Pletea-Marinescu-Valentin/Stabilization-Platform/results/tables/cost.tex

\begin{table}[!ht]
\centering
\caption{Cost of one update on the \SI{600}{\mega\hertz} Cortex-M7, against a \SI{31.25}{\milli\second} budget.}
\label{tab:cost}
\begin{tabular}{lccc}
\toprule
Controller & flops & time [\si{\micro\second}] & budget [\%] \\
\midrule
PID & 14 & 0.023 & 0.0001 \\
RST & 16 & 0.027 & 0.0001 \\
LQR & 12 & 0.020 & 0.0001 \\
LQG & 26 & 0.043 & 0.0001 \\
MRAC & 60 & 0.100 & 0.0003 \\
\bottomrule
\end{tabular}
\end{table}
