Pletea-Marinescu-Valentin/Stabilization-Platform/results/tables/results_acq.tex

\begin{table}[!ht]
\centering
\caption{Acquisition window (\SIrange{1}{20}{\second}): recovery from a \SI{6}{\degree} step of base tilt. Score is normalised against the best controller in each row group; lower is better.}
\label{tab:acq}
\footnotesize
\setlength{\tabcolsep}{3pt}
\begin{tabular}{llccccc}
\toprule
Case & Ctrl & RMSE & IAE & Peak & Effort & Score \\
\midrule
\multicolumn{7}{l}{\textit{Roll axis}} \\
Empty cup & PID & 0.51 & 1.5 & 5.99 & 0.19 & 1.12 \\
 & RST & 0.59 & 1.8 & \textbf{5.99} & \textbf{0.18} & 1.25 \\
 & LQR & \textbf{0.47} & \textbf{1.2} & 6.01 & 0.23 & \textbf{1.04} \\
 & LQG & 0.55 & 1.6 & 6.00 & 0.20 & 1.18 \\
 & MRAC & 0.59 & 2.1 & 5.99 & 0.18 & 1.35 \\
\addlinespace[2pt]
Half full & PID & 0.51 & 1.9 & 5.99 & 0.20 & \textbf{1.06} \\
 & RST & 0.59 & \textbf{1.8} & \textbf{5.99} & \textbf{0.18} & 1.06 \\
 & LQR & \textbf{0.47} & 2.0 & 6.01 & 0.27 & 1.11 \\
 & LQG & 0.55 & 2.0 & 6.00 & 0.22 & 1.11 \\
 & MRAC & 0.59 & 2.0 & 5.99 & 0.19 & 1.11 \\
\addlinespace[2pt]
Three-quarters full & PID & 0.51 & 2.0 & 5.99 & 0.20 & 1.07 \\
 & RST & 0.59 & \textbf{1.8} & \textbf{5.99} & \textbf{0.18} & \textbf{1.06} \\
 & LQR & \textbf{0.47} & 2.1 & 6.01 & 0.27 & 1.14 \\
 & LQG & 0.55 & 2.1 & 6.00 & 0.22 & 1.13 \\
 & MRAC & 0.59 & 2.0 & 5.99 & 0.19 & 1.10 \\
\midrule
\multicolumn{7}{l}{\textit{Pitch axis}} \\
Empty cup & PID & 0.77 & 3.6 & 5.99 & \textbf{0.06} & 1.73 \\
 & RST & 0.59 & 1.8 & \textbf{5.99} & 0.07 & \textbf{1.19} \\
 & LQR & \textbf{0.50} & \textbf{1.5} & 6.01 & 0.27 & 1.58 \\
 & LQG & 0.63 & 2.0 & 6.00 & 0.14 & 1.46 \\
 & MRAC & 0.59 & 2.3 & 5.99 & 0.07 & 1.34 \\
\addlinespace[2pt]
Half full & PID & 0.77 & 4.2 & 5.99 & \textbf{0.06} & 1.89 \\
 & RST & 0.59 & 1.9 & \textbf{5.99} & 0.07 & \textbf{1.18} \\
 & LQR & \textbf{0.50} & \textbf{1.5} & 6.01 & 0.27 & 1.54 \\
 & LQG & 0.63 & 2.1 & 6.00 & 0.14 & 1.44 \\
 & MRAC & 0.59 & 2.3 & 5.99 & 0.07 & 1.30 \\
\addlinespace[2pt]
Three-quarters full & PID & 0.78 & 4.4 & 5.99 & \textbf{0.06} & 1.95 \\
 & RST & 0.59 & 1.8 & \textbf{5.99} & 0.07 & \textbf{1.18} \\
 & LQR & \textbf{0.50} & \textbf{1.5} & 6.01 & 0.27 & 1.52 \\
 & LQG & 0.63 & 2.1 & 6.00 & 0.14 & 1.43 \\
 & MRAC & 0.59 & 2.2 & 5.99 & 0.07 & 1.28 \\
\bottomrule
\end{tabular}
\end{table}
