Pletea-Marinescu-Valentin/Stabilization-Platform/results/tables/results_dist.tex

\begin{table}[!ht]
\centering
\caption{Disturbance window (\SIrange{20}{80}{\second}): trapezoidal tilts, rocking and a sweep through the slosh band.}
\label{tab:dist}
\footnotesize
\setlength{\tabcolsep}{3pt}
\begin{tabular}{llccccc}
\toprule
Case & Ctrl & RMSE & IAE & Peak & Effort & Score \\
\midrule
\multicolumn{7}{l}{\textit{Roll axis}} \\
Empty cup & PID & 1.15 & 47.6 & 5.99 & 1.59 & 1.09 \\
 & RST & 1.26 & 52.5 & 5.99 & \textbf{1.34} & 1.13 \\
 & LQR & \textbf{1.10} & \textbf{42.7} & \textbf{5.98} & 1.86 & \textbf{1.06} \\
 & LQG & 1.23 & 50.4 & 5.99 & 1.61 & 1.13 \\
 & MRAC & 1.24 & 51.9 & 6.01 & 1.46 & 1.13 \\
\addlinespace[2pt]
Half full & PID & 1.15 & 50.5 & 5.96 & 1.67 & 1.08 \\
 & RST & 1.26 & 53.0 & 6.00 & \textbf{1.34} & 1.08 \\
 & LQR & \textbf{1.11} & \textbf{47.3} & \textbf{5.93} & 2.01 & \textbf{1.07} \\
 & LQG & 1.24 & 53.8 & 6.00 & 1.69 & 1.13 \\
 & MRAC & 1.24 & 52.1 & 5.99 & 1.46 & 1.08 \\
\addlinespace[2pt]
Three-quarters full & PID & 1.16 & 51.1 & 6.03 & 1.69 & 1.06 \\
 & RST & 1.26 & 53.1 & \textbf{5.98} & \textbf{1.34} & \textbf{1.06} \\
 & LQR & \textbf{1.13} & \textbf{49.3} & 6.08 & 2.06 & 1.08 \\
 & LQG & 1.24 & 54.0 & 6.00 & 1.70 & 1.10 \\
 & MRAC & 1.24 & 52.2 & 6.00 & 1.46 & 1.06 \\
\midrule
\multicolumn{7}{l}{\textit{Pitch axis}} \\
Empty cup & PID & 1.66 & 76.6 & 5.99 & \textbf{0.34} & 1.43 \\
 & RST & 1.26 & 52.5 & 5.99 & 0.45 & 1.16 \\
 & LQR & \textbf{1.08} & \textbf{44.1} & 5.99 & 0.57 & \textbf{1.10} \\
 & LQG & 1.35 & 57.6 & 5.98 & 0.47 & 1.24 \\
 & MRAC & 1.29 & 51.3 & \textbf{5.97} & 0.60 & 1.23 \\
\addlinespace[2pt]
Half full & PID & 1.68 & 80.5 & 6.02 & \textbf{0.36} & 1.47 \\
 & RST & 1.27 & 53.4 & 6.00 & 0.45 & 1.16 \\
 & LQR & \textbf{1.08} & \textbf{44.3} & 5.99 & 0.58 & \textbf{1.09} \\
 & LQG & 1.36 & 58.6 & 5.99 & 0.47 & 1.24 \\
 & MRAC & 1.31 & 54.1 & \textbf{5.98} & 0.62 & 1.25 \\
\addlinespace[2pt]
Three-quarters full & PID & 1.68 & 80.6 & \textbf{5.95} & \textbf{0.36} & 1.46 \\
 & RST & 1.27 & 53.6 & 5.99 & 0.45 & 1.16 \\
 & LQR & \textbf{1.08} & \textbf{44.5} & 5.99 & 0.57 & \textbf{1.09} \\
 & LQG & 1.36 & 58.6 & 5.99 & 0.47 & 1.24 \\
 & MRAC & 1.32 & 53.8 & 5.98 & 0.61 & 1.25 \\
\bottomrule
\end{tabular}
\end{table}
