Pletea-Marinescu-Valentin/Stabilization-Platform/results/tables/scores.tex

\begin{table}[!ht]
\centering
\caption{Composite score, normalised against the best controller of each case (1.00 = best). Lower is better; bold marks each column's best.}
\label{tab:scores}
\footnotesize
\setlength{\tabcolsep}{4pt}
\begin{tabular}{ll ccc ccc}
\toprule
& & \multicolumn{3}{c}{Roll} & \multicolumn{3}{c}{Pitch} \\
\cmidrule(lr){3-5}\cmidrule(lr){6-8}
Window & Ctrl & empty & half & 3/4 & empty & half & 3/4 \\
\midrule
Acquis. & PID & 1.12 & \textbf{1.06} & 1.07 & 1.73 & 1.89 & 1.95 \\
 & RST & 1.25 & 1.06 & \textbf{1.06} & \textbf{1.19} & \textbf{1.18} & \textbf{1.18} \\
 & LQR & \textbf{1.04} & 1.11 & 1.14 & 1.58 & 1.54 & 1.52 \\
 & LQG & 1.18 & 1.11 & 1.13 & 1.46 & 1.44 & 1.43 \\
 & MRAC & 1.35 & 1.11 & 1.10 & 1.34 & 1.30 & 1.28 \\
\midrule
Disturb. & PID & 1.09 & 1.08 & 1.06 & 1.43 & 1.47 & 1.46 \\
 & RST & 1.13 & 1.08 & \textbf{1.06} & 1.16 & 1.16 & 1.16 \\
 & LQR & \textbf{1.06} & \textbf{1.07} & 1.08 & \textbf{1.10} & \textbf{1.09} & \textbf{1.09} \\
 & LQG & 1.13 & 1.13 & 1.10 & 1.24 & 1.24 & 1.24 \\
 & MRAC & 1.13 & 1.08 & 1.06 & 1.23 & 1.25 & 1.25 \\
\bottomrule
\end{tabular}
\end{table}
