Pletea-Marinescu-Valentin/Stabilization-Platform/results/tables/sensitivity.tex

\begin{table}[!ht]
\centering
\caption{Share of weight vectors drawn uniformly from the simplex for which each controller scores best.}
\label{tab:sensitivity}
\begin{tabular}{llccccc}
\toprule
Axis & Window & PID & RST & LQR & LQG & MRAC \\
\midrule
Roll & Acquisition & 29 & \textbf{41} & 29 & 0 & 0 \\
Roll & Disturbance & 13 & \textbf{54} & 33 & 0 & 1 \\
Pitch & Acquisition & 4 & \textbf{84} & 12 & 0 & 0 \\
Pitch & Disturbance & 13 & 30 & \textbf{57} & 0 & 0 \\
\bottomrule
\end{tabular}
\end{table}
