Pletea-Marinescu-Valentin/Stabilization-Platform/results/tables/verification.tex

\begin{table}[!ht]
\centering
\caption{Achieved margins and plant-error tolerance. $M_s$ is matched by construction; $\omega_B$ is what that equal margin bought.}
\label{tab:verification}
\begin{tabular}{llccccc}
\toprule
Axis & Ctrl & $\omega_B$ & $M_s$ & PM & $\Delta K$ & $\Delta\omega_n$ \\
 & & [\si{\radian\per\second}] & & [\si{\degree}] & [\si{\decibel}] & [\%] \\
\midrule
Roll & PID & 5.26 & 1.30 & 79 & 6.8 & 77 \\
 & RST & 5.87 & 1.30 & 69 & 8.9 & 150 \\
 & LQR & 7.99 & 1.30 & 75 & 7.0 & 43 \\
 & LQG & 5.84 & 1.30 & 75 & 7.0 & 73 \\
 & MRAC & 5.87 & 1.30 & 69 & 8.9 & 150 \\
\midrule
Pitch & PID & 1.82 & 1.30 & 85 & 6.6 & 105 \\
 & RST & 5.87 & 1.30 & 69 & 8.9 & 73 \\
 & LQR & 5.98 & 1.30 & 77 & 6.8 & 27 \\
 & LQG & 4.42 & 1.30 & 75 & 7.0 & 43 \\
 & MRAC & 5.87 & 1.30 & 69 & 8.9 & 73 \\
\bottomrule
\end{tabular}
\end{table}
