Pletea-Marinescu-Valentin/Stabilization-Platform/results/tables/rawpitch.tex

\begin{table}[!ht]
\centering
\caption{Pitch, disturbance window: raw metrics in degrees. Filling the cup moves RMSE by at most \SI{2.1}{\percent} (MRAC), so the rows are separated by structure, not payload.}
\label{tab:rawpitch}
\footnotesize
\begin{tabular}{lcccccc}
\toprule
& \multicolumn{2}{c}{Empty} & \multicolumn{2}{c}{Half full} & \multicolumn{2}{c}{3/4 full} \\
\cmidrule(lr){2-3}\cmidrule(lr){4-5}\cmidrule(lr){6-7}
Ctrl & RMSE & peak & RMSE & peak & RMSE & peak \\
\midrule
PID & 1.66 & 5.99 & 1.68 & 6.02 & 1.68 & 5.95 \\
RST & 1.26 & 5.99 & 1.27 & 6.00 & 1.27 & 5.99 \\
LQR & 1.08 & 5.99 & 1.08 & 5.99 & 1.08 & 5.99 \\
LQG & 1.35 & 5.98 & 1.36 & 5.99 & 1.36 & 5.99 \\
MRAC & 1.29 & 5.97 & 1.31 & 5.98 & 1.32 & 5.98 \\
\bottomrule
\end{tabular}
\end{table}
