Pletea-Marinescu-Valentin/Stabilization-Platform/results/tables/scenarios.tex

\begin{table}[!ht]
\centering
\caption{Payload scenarios. Inertia lowers each resonance as $\sqrt{J_0/J}$; the liquid adds a slosh mode at $\omega_s$. Frequencies in \si{\radian\per\second}.}
\label{tab:scenarios}
\setlength{\tabcolsep}{4pt}
\begin{tabular}{lccccc}
\toprule
Case & $m$ [\si{\gram}] & $\omega_n^{\mathrm{roll}}$ & $\omega_n^{\mathrm{pitch}}$ & $\omega_s$ & $\zeta_s$ \\
\midrule
Empty & 334 & 46.7 & 26.2 & -- & -- \\
Half & 467 & 44.3 & 24.9 & 22.6 & 0.0060 \\
3/4 full & 581 & 42.6 & 23.9 & 22.7 & 0.0059 \\
\bottomrule
\end{tabular}
\end{table}
