Pletea-Marinescu-Valentin/Stabilization-Platform/results/tables/slosh.tex

\begin{table}[!ht]
\centering
\caption{Slosh margin $\zeta_s/\zeta_s^{\mathrm{crit}}$, predicted with the analytical doublet added; $\zeta_s^{\mathrm{crit}}$ is the least liquid damping that keeps the loop stable. Bold marks the largest of each row, underline a margin below one. The empty cup has no such mode.}
\label{tab:slosh}
\begin{tabular}{llccccc}
\toprule
Axis & Case & PID & RST & LQR & LQG & MRAC \\
\midrule
Roll & Half full & \textbf{6.05} & 4.04 & \textbf{6.05} & 2.42 & 4.04 \\
Roll & Three-quarters full & \textbf{5.86} & 3.91 & \textbf{5.86} & 2.35 & 3.91 \\
Pitch & Half full & 2.02 & 3.03 & \textbf{6.05} & 2.02 & 3.03 \\
Pitch & Three-quarters full & \underline{0.90} & 2.35 & \textbf{5.86} & 2.35 & 2.35 \\
\bottomrule
\end{tabular}
\end{table}
