Pletea-Marinescu-Valentin/Stabilization-Platform/results/metrics.csv

axis | scenario | controller | window | RMSE | MAE | peak | IAE | ISE | effort | u_rms | u_max | sse | in_1deg | in_2deg
roll | empty | pid | acq | 0.5132636633019707 | 0.0801252262029996 | 5.993641734124218 | 1.5223792978569923 | 5.005352173257016 | 0.1858289767063339 | 2.6836361566170104 | 2.7152687626379817 | -0.010312130795093494 | 98.19078947368422 | 98.68421052631578
roll | empty | pid | dist | 1.1505976654104682 | 0.7933903521391376 | 5.9855884868098626 | 47.60342112834825 | 79.4324992588812 | 1.58977275817981 | 1.207530805512814 | 3.158142607869806 | -0.0075325666927612625 | 63.33333333333333 | 87.76041666666666
roll | empty | rst | acq | 0.5911875234306094 | 0.09540468248898461 | 5.988690450711608 | 1.8126889672907076 | 6.640551069340331 | 0.17847745768068468 | 2.6831241659188003 | 2.8121500697155195 | -0.011834571336878902 | 98.02631578947368 | 98.35526315789474
roll | empty | rst | dist | 1.2632611681124748 | 0.874563265776742 | 5.986037294702756 | 52.473795946604525 | 95.74972673165365 | 1.3388597534713194 | 1.2214337003057791 | 3.2487976079686454 | -0.0072128344452256354 | 59.27083333333333 | 86.09375
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
