Pletea-Marinescu-Valentin/Stabilization-Platform/results/tables/models.tex

\begin{table}[!ht]
\centering
\caption{Identified axis models, $G(s)=K\omega_n^2/(s^2+2\zeta\omega_n s+\omega_n^2)\,e^{-\tau s}$; fit is the cross-validated free-run fit.}
\label{tab:models}
\begin{tabular}{lccccc}
\toprule
Axis & $K$ [\si{\degree\per\degree}] & $\omega_n$ [\si{\radian\per\second}] & $f_n$ [\si{\hertz}] & $\zeta$ & fit [\%] \\
\midrule
Roll & -2.219 & 46.67 & 7.43 & 0.143 & 58.2 \\
Pitch & -6.215 & 26.22 & 4.17 & 0.121 & 78.3 \\
\bottomrule
\end{tabular}
\end{table}
