Pletea-Marinescu-Valentin/Stabilization-Platform/results/run_pitch_lqg_empty.csv

time_s | base_tilt_deg | angle_deg | error_deg | command_deg
0.00000 | 0.0000 | 0.0000 | 0.0000 | 0.0000
0.03125 | 0.0000 | 0.0000 | 0.0000 | 0.0017
0.06250 | 0.0000 | 0.0000 | 0.0000 | -0.0029
0.09375 | 0.0000 | -0.0061 | 0.0061 | 0.0024
0.12500 | 0.0000 | 0.0028 | -0.0028 | 0.0017
0.15625 | 0.0000 | -0.0001 | 0.0001 | -0.0016
0.18750 | 0.0000 | -0.0087 | 0.0087 | 0.0030
0.21875 | 0.0000 | -0.0050 | 0.0050 | -0.0016
0.25000 | 0.0000 | -0.0097 | 0.0097 | 0.0032
0.28125 | 0.0000 | -0.0023 | 0.0023 | 0.0010
0.31250 | 0.0000 | -0.0065 | 0.0065 | 0.0006
0.34375 | 0.0000 | -0.0096 | 0.0096 | -0.0024
0.37500 | 0.0000 | -0.0087 | 0.0087 | 0.0051
0.40625 | 0.0000 | 0.0055 | -0.0055 | -0.0027
0.43750 | 0.0000 | -0.0042 | 0.0042 | -0.0020
0.46875 | 0.0000 | -0.0002 | 0.0002 | 0.0034
0.50000 | 0.0000 | 0.0105 | -0.0105 | -0.0041
0.53125 | 0.0000 | 0.0012 | -0.0012 | 0.0028
0.56250 | 0.0000 | 0.0075 | -0.0075 | -0.0020
0.59375 | 0.0000 | -0.0015 | 0.0015 | 0.0016
0.62500 | 0.0000 | -0.0009 | 0.0009 | -0.0009
0.65625 | 0.0000 | -0.0056 | 0.0056 | 0.0012
0.68750 | 0.0000 | -0.0032 | 0.0032 | 0.0029
0.71875 | 0.0000 | -0.0035 | 0.0035 | -0.0003
0.75000 | 0.0000 | -0.0121 | 0.0121 | 0.0038
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
