Pletea-Marinescu-Valentin/Stabilization-Platform/results/run_pitch_lqg_half.csv

time_s | base_tilt_deg | angle_deg | error_deg | command_deg
0.00000 | 0.0000 | 0.0000 | 0.0000 | 0.0000
0.03125 | 0.0000 | 0.0000 | 0.0000 | 0.0017
0.06250 | 0.0000 | 0.0000 | 0.0000 | -0.0029
0.09375 | 0.0000 | -0.0058 | 0.0058 | 0.0024
0.12500 | 0.0000 | 0.0023 | -0.0023 | 0.0017
0.15625 | 0.0000 | -0.0002 | 0.0002 | -0.0016
0.18750 | 0.0000 | -0.0082 | 0.0082 | 0.0030
0.21875 | 0.0000 | -0.0051 | 0.0051 | -0.0016
0.25000 | 0.0000 | -0.0097 | 0.0097 | 0.0032
0.28125 | 0.0000 | -0.0029 | 0.0029 | 0.0010
0.31250 | 0.0000 | -0.0066 | 0.0066 | 0.0006
0.34375 | 0.0000 | -0.0093 | 0.0093 | -0.0024
0.37500 | 0.0000 | -0.0085 | 0.0085 | 0.0051
0.40625 | 0.0000 | 0.0049 | -0.0049 | -0.0027
0.43750 | 0.0000 | -0.0037 | 0.0037 | -0.0020
0.46875 | 0.0000 | 0.0001 | -0.0001 | 0.0034
0.50000 | 0.0000 | 0.0102 | -0.0102 | -0.0041
0.53125 | 0.0000 | 0.0016 | -0.0016 | 0.0028
0.56250 | 0.0000 | 0.0075 | -0.0075 | -0.0020
0.59375 | 0.0000 | -0.0011 | 0.0011 | 0.0016
0.62500 | 0.0000 | -0.0010 | 0.0010 | -0.0009
0.65625 | 0.0000 | -0.0058 | 0.0058 | 0.0012
0.68750 | 0.0000 | -0.0037 | 0.0037 | 0.0029
0.71875 | 0.0000 | -0.0038 | 0.0038 | -0.0003
0.75000 | 0.0000 | -0.0116 | 0.0116 | 0.0038
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
