Pletea-Marinescu-Valentin/Stabilization-Platform/results/run_pitch_lqr_empty.csv

time_s | base_tilt_deg | angle_deg | error_deg | command_deg
0.00000 | 0.0000 | 0.0000 | 0.0000 | 0.0040
0.03125 | 0.0000 | 0.0000 | 0.0000 | -0.0074
0.06250 | 0.0000 | -0.0144 | 0.0144 | 0.0062
0.09375 | 0.0000 | 0.0087 | -0.0087 | -0.0018
0.12500 | 0.0000 | 0.0004 | -0.0004 | 0.0005
0.15625 | 0.0000 | -0.0003 | 0.0003 | 0.0039
0.18750 | 0.0000 | -0.0025 | 0.0025 | -0.0074
0.21875 | 0.0000 | -0.0167 | 0.0167 | 0.0062
0.25000 | 0.0000 | 0.0077 | -0.0077 | -0.0018
0.28125 | 0.0000 | 0.0011 | -0.0011 | 0.0005
0.31250 | 0.0000 | 0.0014 | -0.0014 | -0.0082
0.34375 | 0.0000 | -0.0010 | 0.0010 | 0.0109
0.37500 | 0.0000 | 0.0269 | -0.0269 | -0.0090
0.40625 | 0.0000 | -0.0047 | 0.0047 | 0.0008
0.43750 | 0.0000 | 0.0045 | -0.0045 | 0.0020
0.46875 | 0.0000 | 0.0067 | -0.0067 | -0.0047
0.50000 | 0.0000 | -0.0024 | 0.0024 | 0.0054
0.53125 | 0.0000 | 0.0082 | -0.0082 | -0.0038
0.56250 | 0.0000 | -0.0070 | 0.0070 | 0.0069
0.59375 | 0.0000 | -0.0018 | 0.0018 | -0.0024
0.62500 | 0.0000 | -0.0214 | 0.0214 | 0.0044
0.65625 | 0.0000 | -0.0164 | 0.0164 | 0.0024
0.68750 | 0.0000 | -0.0185 | 0.0185 | 0.0030
0.71875 | 0.0000 | -0.0182 | 0.0182 | 0.0028
0.75000 | 0.0000 | -0.0181 | 0.0181 | -0.0012
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
