Pletea-Marinescu-Valentin/Stabilization-Platform/results/run_pitch_lqr_full.csv

time_s | base_tilt_deg | angle_deg | error_deg | command_deg
0.00000 | 0.0000 | 0.0000 | 0.0000 | 0.0040
0.03125 | 0.0000 | 0.0000 | 0.0000 | -0.0074
0.06250 | 0.0000 | -0.0128 | 0.0128 | 0.0062
0.09375 | 0.0000 | 0.0064 | -0.0064 | -0.0018
0.12500 | 0.0000 | -0.0002 | 0.0002 | 0.0005
0.15625 | 0.0000 | -0.0000 | 0.0000 | 0.0039
0.18750 | 0.0000 | -0.0015 | 0.0015 | -0.0074
0.21875 | 0.0000 | -0.0144 | 0.0144 | 0.0062
0.25000 | 0.0000 | 0.0054 | -0.0054 | -0.0018
0.28125 | 0.0000 | -0.0001 | 0.0001 | 0.0005
0.31250 | 0.0000 | 0.0009 | -0.0009 | -0.0082
0.34375 | 0.0000 | -0.0003 | 0.0003 | 0.0109
0.37500 | 0.0000 | 0.0248 | -0.0248 | -0.0090
0.40625 | 0.0000 | -0.0010 | 0.0010 | 0.0008
0.43750 | 0.0000 | 0.0061 | -0.0061 | 0.0020
0.46875 | 0.0000 | 0.0066 | -0.0066 | -0.0047
0.50000 | 0.0000 | -0.0026 | 0.0026 | 0.0054
0.53125 | 0.0000 | 0.0056 | -0.0056 | -0.0038
0.56250 | 0.0000 | -0.0071 | 0.0071 | 0.0069
0.59375 | 0.0000 | -0.0023 | 0.0023 | -0.0024
0.62500 | 0.0000 | -0.0189 | 0.0189 | 0.0044
0.65625 | 0.0000 | -0.0158 | 0.0158 | 0.0024
0.68750 | 0.0000 | -0.0189 | 0.0189 | 0.0030
0.71875 | 0.0000 | -0.0196 | 0.0196 | 0.0028
0.75000 | 0.0000 | -0.0196 | 0.0196 | -0.0012
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
