Pletea-Marinescu-Valentin/Stabilization-Platform/(commit log)

2026-02-02 Update Teensy firmware with PID, RST, LQG, MRAC controllers
2026-02-02 Add experimental datasets for system identification and controller logs
    [log_adaptive.csv, log_lqr.csv, log_pid.csv, log_rst.csv, pitch_id.csv, roll_id.csv]
2026-02-04 Refactor loop timing: fixed-interval scheduler and add loop-period logger
    [HoldMyCoffee_Teensy.ino]
2026-03-16 fix: pitch problem at stabilization + negative DIST because of negative cos
    [HoldMyCoffee_UNO.ino]
2026-03-16 fix:issue for roll control by faulting
    [HoldMyCoffee_Teensy.ino]
2026-03-19 fix: issue of unstable MRAC
    [HoldMyCoffee_Teensy.ino]
2026-03-19 update data obtained by testing and validation
    [log_adaptive.csv, log_adaptive_empty.csv, log_adaptive_full.csv, log_adaptive_half.csv, log_lqg_empty.csv, log_lqg_full.csv, log_lqg_half.csv, log_lqr.csv]
2026-04-22 new arhitecure for dashboard, shown metrics, desciption for control mode and added 2 axes for +-2 degree error
    [dashboard.py]
2026-07-31 Rebuild the controller study around an equal-robustness protocol
    Replace the MATLAB scripts with a Python toolchain that runs the whole
    study from the raw PRBS records: identification, design, simulation,
    metrics, figures, LaTeX tables and the firmware constants header.
    Identification
    - Estimate a delayed second-order model per axis by output error, with
    order selection on a held-out split. Both axes come out minimum-phase:
    the numerator zero moves from -0.30 to -2.32 across sub-records and is
    not identifiable, so the non-minimum-phase behaviour reported earlier
    was an artefact of an over-parameterised numerator.
    - Estimate the two-sample (62.5 ms) transport delay from the data. It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
    [log_adaptive_empty.csv, log_adaptive_full.csv, log_adaptive_half.csv, log_lqg_empty.csv, log_lqg_full.csv, log_lqg_half.csv, log_pid_empty.csv, log_pid_full.csv]
2026-08-01 Publish the generated results
    Commit the run CSVs, metrics, summary and LaTeX tables so the numbers in
    the paper can be checked without running the pipeline. results/README.md
    states what they are: closed-loop runs evaluated on the models identified
    from the PRBS experiments, not hardware logs.
    [metrics.csv, run_pitch_lqg_empty.csv, run_pitch_lqg_full.csv, run_pitch_lqg_half.csv, run_pitch_lqr_empty.csv, run_pitch_lqr_full.csv, run_pitch_lqr_half.csv, run_pitch_mrac_empty.csv]
2026-08-01 Quantify identification uncertainty and its effect on the ranking
    Refit the axis models on 150 random blocks of each PRBS record and
    re-evaluate the five fixed designs on every resampled plant. The slowest
    structure is unchanged in 100% of draws on both axes; the full ordering
    survives in 100% on pitch and 73% on roll, where RST, LQR and MRAC sit
    within 0.02 rad/s of each other. Worst peak sensitivity stays under 1.40.
    Also drop 'measured' from the composite-score table caption, which was
    inconsistent with the paper stating the comparison is model-based.
2026-08-27 Rewrite system identification with cross-validated structure selection
    Resample each record onto its own mean sample interval, high-pass both
    channels at 0.1 Hz, and select model order, numerator structure and transport
    delay by blocked five-fold cross-validation on the free-run fit, screened
    against the Welch estimate of the measured frequency response. Both axes now
    select a two-sample delay from the data instead of assuming it. Report
    residual whiteness, coherence and the amplitude dependence of the roll gain,
    and replace the full-permutation ranking agreement with pairwise stability so
    exact ties are not counted as disagreement.
2026-08-27 Refine the equal-robustness search so all five designs reach Ms = 1.30
    The coarse grids left RST and MRAC at Ms 1.310 while LQR stopped at 1.257,
    which is not an equal constraint. Refine locally around the coarse incumbent
    for every structure and drop the 0.01 tolerance. Nine of ten loops now land
    within 0.001 of the target; roll PID stops at 1.28 because its achievable Ms
    jumps from 1.284 to 1.312 between adjacent designs.
2026-08-27 Shorten table captions and pin float placement
    Captions were longer than needed and tables floated away from their citation.
    Use [!ht] throughout and make table_scenarios tolerate a null slosh mode so
    the tables regenerate from summary.json.
2026-08-27 Regenerate results and firmware constants
    Roll K=-2.219, wn=46.67 rad/s, zeta=0.143; pitch K=-6.215, wn=26.22 rad/s,
    zeta=0.121, both with a two-sample delay. At Ms = 1.30 the bandwidths are
    LQR > RST = MRAC > LQG > PID on both axes.
    [metrics.csv, run_pitch_lqg_empty.csv, run_pitch_lqg_full.csv, run_pitch_lqg_half.csv, run_pitch_lqr_empty.csv, run_pitch_lqr_full.csv, run_pitch_lqr_half.csv, run_pitch_mrac_empty.csv]
2026-09-04 Report loop shape, numerator stability and LQG separation
    The equal-robustness search left several claims resting on quantities the
    pipeline never computed. Add the missing measurements and split the run
    figures so five traces are no longer stacked on one pair of axes.
    design.py
    sensitivity_integral area under |S| over the disturbance band, so the
    designs can be compared beyond the single Ms point
    pid_granularity how finely PID can spend the Ms budget, swept
    locally around the selected wc rather than over the
    whole range
    damping_remedy what a better-damped inner loop would buy on pitch
    separ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
    [metrics.csv, run_pitch_pid_empty.csv, run_pitch_pid_full.csv, run_pitch_pid_half.csv, run_roll_pid_empty.csv, run_roll_pid_full.csv, run_roll_pid_half.csv]
